aknuds1/electrosmash-pedalshield/README.md

# ElectroSmash pedalSHIELD
Description of [ElectroSmash pedalSHIELD](http://www.electrosmash.com/pedalshield) DIY guitar
pedal, along with instructions for how to build it yourself.
