aknuds1/electrosmash-pedalshield/muzhack/files/pedalSHIELD_a.stl

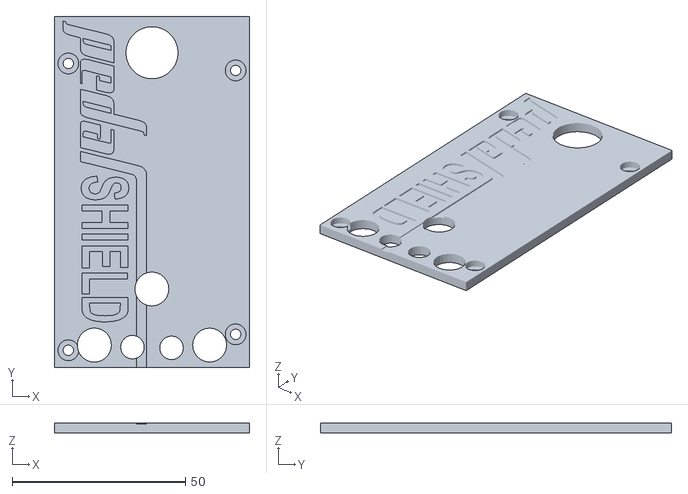
[picture p2: CAD file, 2016-08-24]
muzhack/files/pedalSHIELD_a.stl
56.3 x 101.4 x 3.00
