aknuds1/electrosmash-pedalshield/(list of files, drawings)

Other design files:
muzhack/files/PedalShield rev.E - native files/kicad schematics/pedal shield.dsn
