aknuds1/electrosmash-pedalshield/muzhack/files/PedalShield rev.E - native files/kicad schematics/pedal shield.kicad_pcb

## KiCad design muzhack/files/PedalShield rev.E - native files/kicad schematics/pedal shield.kicad_pcb (2016-08-24)

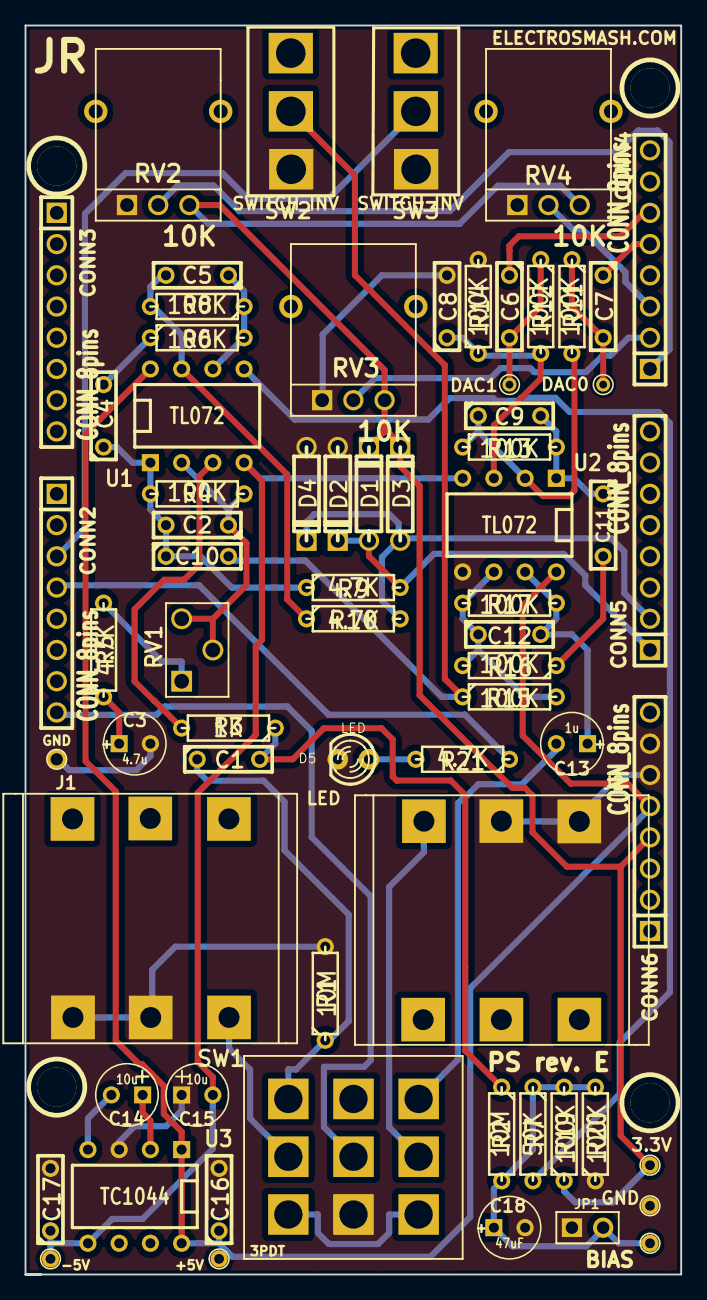
[picture p3: board pedal shield.kicad_pcb from above]

Board: 2 copper layers, 53.3 x 101.6 mm, 73 parts (0 on the bottom side), 42 nets.

Parts:
C1, C4, C6, C7, C10, C11: 0.1u; C2
C2, C5, C8, C9, C12: 47p; C2
C3: 4.7u; C1V5
C13: 1u; C1V5
C14, C15: 10u; C1V5
C16, C17: 100n; C2
C18: 47uF; C1V5
CONN2, CONN3, CONN4, CONN5, CONN6: CONN_8pins; SIL-8
D1, D2, D3, D4: 1N5817; D3
D5: LED; LED-3MM
J1: Guitar_IN; JACK_AUDIO
J2: OUTPUT; JACK_AUDIO
JP1: JUMPER; PIN_ARRAY_2X1
R1, R2: 10M; R3
R3: 1K; R3
R4, R6, R8, R11, R12, R13, R14, R15, R16, R17, R19, R20: 100K; R3
R5, R9, R10, R21: 4.7K; R3
R7: 50K; R3
RV1: 500K; PIN_ARRAY_3X1
RV2, RV3, RV4: 10K; RVAR
SW1: SWITCH_3PDT; 3PDT
SW2: SWITCH_INV; SW_SPDT_pedalSHIELD
SW3: SWITCH_INV; SW_SPDT
TP1: 3V3 TP; PINTST
TP2: 1V6 TP; PINTST
TP3, TP6: GND TP; PINTST
TP4: +5V TP; PINTST
TP5: -5V TP; PINTST
TP7: DAC0; PINTST
TP8: DAC1; PINTST
U1, U2: TL072; DIP-8__300
U3: TC1044; DIP-8__300
hole1: hole1; 1pin
hole2, hole3, hole4: P***; 1pin

Connections:
+3.3V: CONN6.4, D1.2, D3.2, R19.1, RV2.3, RV3.3, RV4.3, TP1.1
+5V: C16.1, CONN6.5, TP4.1, U1.8, U2.8, U3.1, U3.8
-5V: C15.1, C17.1, TP5.1, U1.4, U2.4, U3.5
/AD0: CONN5.1, D1.1, D2.2, R9.2
/AD1: CONN5.2, D3.1, D4.2, R10.2
/AD8: CONN4.1, RV2.2
/AD9: CONN4.2, RV3.2
/AD10: CONN4.3, RV4.2
/Bypass: SW1.3, SW1.9
/DAC0: C7.1, CONN4.5
/DAC1: C6.1, CONN4.6
/FX In: C1.1, R1.1, SW1.1
/FX Out: C13.2, SW1.7
/IN_BUFFERED: C2.2, C4.1, C10.1, R4.2, R9.1, U1.1
/Input Jack: J1.1, SW1.2
/Output JAck: J2.1, SW1.8
/PWM2: CONN2.3, SW3.2
/PWM3: CONN2.4, R21.1
/PWM7: CONN2.8, SW1.5
GND: C3.2, C8.2, C15.2, C16.2, C17.2, C18.2, CONN6.6, CONN6.7, D2.1, D4.1, D5.2, J1.2, J1.3, J2.2, J2.3, JP1.1, R1.2, R14.2, R20.1, RV2.1, RV3.1, RV4.1, SW1.6, SW2.1, SW3.1, TP3.1, TP6.1, U2.5, U3.3
unnamed: D5.1, R21.2
unnamed: C18.1, JP1.2, R2.2, R7.1, R19.2, R20.2, TP2.1
unnamed: C2.1, R4.1, RV1.2, RV1.3, U1.2
unnamed: C3.1, R5.1
unnamed: R5.2, RV1.1
unnamed: C9.2, C11.1, R13.2, U2.1
unnamed: C12.2, C13.1, R17.2, U2.7
unnamed: C11.2, R16.1
unnamed: C8.1, R12.2, R14.1, U2.3
unnamed: C12.1, R15.2, R16.2, R17.1, U2.6
unnamed: C14.2, U3.4
unnamed: C14.1, U3.2
unnamed: R7.2, U1.5
unnamed: C10.2, R15.1, SW2.2
unnamed: C7.2, R11.1, TP7.1
unnamed: C6.2, R12.1, TP8.1
unnamed: C5.2, R8.2, R10.1, U1.7
unnamed: C5.1, R6.2, R8.1, U1.6
unnamed: C4.2, R6.1
unnamed: R3.2, U1.3
unnamed: C1.2, R2.1, R3.1
unnamed: C9.1, R11.2, R13.1, U2.2
