aknuds1/electrosmash-pedalshield/(commit log)

2016-05-25 Add BOM
2016-05-25 Add more data to BOM
2016-05-30 Fix SoundCloud track
2016-08-02 Update bom
2016-08-04 IMprove BOM
2016-08-05 Remove duplicate BOM
